riple/triple-speed-ethernet-tester/par_easygx/rtl/bustap_jtag/cmd/common/OpenCores.gif

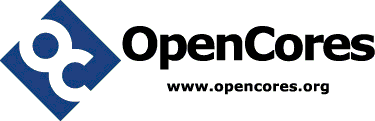
par_easygx/rtl/bustap_jtag/cmd/common/OpenCores.gif
