riple/triple-speed-ethernet-tester/par_easygx/rtl/vjtag_master/gigedemo/gigalite_demo/testsession_setup.txt

# config tx_con-bandwidth
# config tx_con-bandwidth_scaler
# config tx_gen-header_leng
wr 04010000 00220058
wr 04010100 10220010
wr 04010200 20220010
wr 04010300 30220010
wr 04010400 40220010
wr 04010500 50220010
wr 04010600 60220010
wr 04010700 70220010
# config tx_gen-header_content
wr 04010004 10223344
wr 04010008 55660102
wr 0401000c 03040506
wr 04010010 88a83001
wr 04010014 91003002
wr 04010018 81003003
wr 0401001c 88470000
wr 04010020 10800000
wr 04010024 20800000
wr 04010028 31806000
wr 0401002c 00000034
wr 04010030 11630000
wr 04010034 00000000
wr 04010038 00000000
wr 0401003c 0000c0a8
wr 04010040 01650000
wr 04010044 00000000
wr 04010048 00000000
wr 0401004c 0000c0a8
wr 04010050 0165013f
wr 04010054 013f0034
wr 04010058 84600022
wr 0401005c 00000000
wr 04010060 00000000
wr 04010104 11223344
wr 04010108 55661102
wr 0401010c 03040506
wr 04010110 08061022
wr 04010114 33445566
wr 04010118 778899aa
wr 0401011c bbccddee
wr 04010120 ff112233
wr 04010124 44556677
wr 04010128 8899aabb
wr 0401012c ccddeedd
wr 04010204 12223344
wr 04010208 55662102
wr 0401020c 03040506
wr 04010210 08062022
wr 04010214 33445566
wr 04010218 778899aa
wr 0401021c bbccddee
wr 04010220 ff112233
wr 04010224 44556677
wr 04010228 8899aabb
wr 0401022c ccddeedd
wr 04010304 13223344
wr 04010308 55663102
wr 0401030c 03040506
wr 04010310 08063022
wr 04010314 33445566
wr 04010318 778899aa
wr 0401031c bbccddee
wr 04010320 ff112233
wr 04010324 44556677
wr 04010328 8899aabb
wr 0401032c ccddeedd
wr 04010404 14223344
wr 04010408 55664102
wr 0401040c 03040506
wr 04010410 08064022
wr 04010414 33445566
wr 04010418 778899aa
wr 0401041c bbccddee
wr 04010420 ff112233
wr 04010424 44556677
wr 04010428 8899aabb
wr 0401042c ccddeedd
wr 04010504 15223344
wr 04010508 55665102
wr 0401050c 03040506
wr 04010510 08065022
wr 04010514 33445566
wr 04010518 778899aa
wr 0401051c bbccddee
wr 04010520 ff112233
wr 04010524 44556677
wr 04010528 8899aabb
wr 0401052c ccddeedd
wr 04010604 16223344
wr 04010608 55666102
wr 0401060c 03040506
wr 04010610 08066022
wr 04010614 33445566
wr 04010618 778899aa
wr 0401061c bbccddee
wr 04010620 ff112233
wr 04010624 44556677
wr 04010628 8899aabb
wr 0401062c ccddeedd
wr 04010704 17223344
wr 04010708 55667102
wr 0401070c 03040506
wr 04010710 08067022
wr 04010714 33445566
wr 04010718 778899aa
wr 0401071c bbccddee
wr 04010720 ff112233
wr 04010724 44556677
wr 04010728 8899aabb
wr 0401072c ccddeedd
# config tx_header_stat
wr 0401005c 20002020
wr 04010060 40400080
wr 04010114 40800000
wr 04010118 00000080
wr 04010214 20800000
wr 04010218 00000080
wr 04010314 40800000
wr 04010318 00000080
wr 04010414 20800000
wr 04010418 00000080
wr 04010514 40800000
wr 04010518 00000080
wr 04010614 20800000
wr 04010618 00000080
wr 04010714 40800000
wr 04010718 00000080

# config nontest
wr 04010804 aabbccdd
wr 04010808 eeff0102
wr 0401080c 03040506
wr 04010810 0806aaaa
wr 04010de0 5a5a5a5a
wr 04010de4 6b6b6b6b
wr 04010de8 7c7c7c7c
wr 04010dec 20800000
wr 04010df0 00000080
wr 04010df4 00000000
wr 04010800 000005e7
