riple/triple-speed-ethernet-tester/par_imx45t/define.v

`define XILINX_SPARTAN6
`define XILINX

//`define USE_PCIE_CPU_BFM
`define USE_SPI_CPU_BFM
//`define USE_VJTAG_CPU_BFM
//`define USE_VJTAG_CPU_MON

`define USE_PORT0
`define USE_PORT1

`define ENABLE_LOOPBACK
