riple/triple-speed-ethernet-tester/par_imx45t/rtl/buscli-jtag/rtl/xilinx/coregen/chipscope_icon.v

///////////////////////////////////////////////////////////////////////////////
// Copyright (c) 2015 Xilinx, Inc.
// All Rights Reserved
///////////////////////////////////////////////////////////////////////////////
//   ____  ____
//  /   /\/   /
// /___/  \  /    Vendor     : Xilinx
// \   \   \/     Version    : 14.7
//  \   \         Application: Xilinx CORE Generator
//  /   /         Filename   : chipscope_icon.v
// /___/   /\     Timestamp  : Tue Feb 17 22:19:58 中国标准时间 2015
// \   \  /  \
//  \___\/\___\
//
// Design Name: Verilog Synthesis Wrapper
///////////////////////////////////////////////////////////////////////////////
// This wrapper is used to integrate with Project Navigator and PlanAhead

`timescale 1ns/1ps

module chipscope_icon(
    CONTROL0) /* synthesis syn_black_box syn_noprune=1 */;


inout [35 : 0] CONTROL0;

endmodule
